bsce26023/LFR/Custom Sensor Array/Sensor Array.pdf

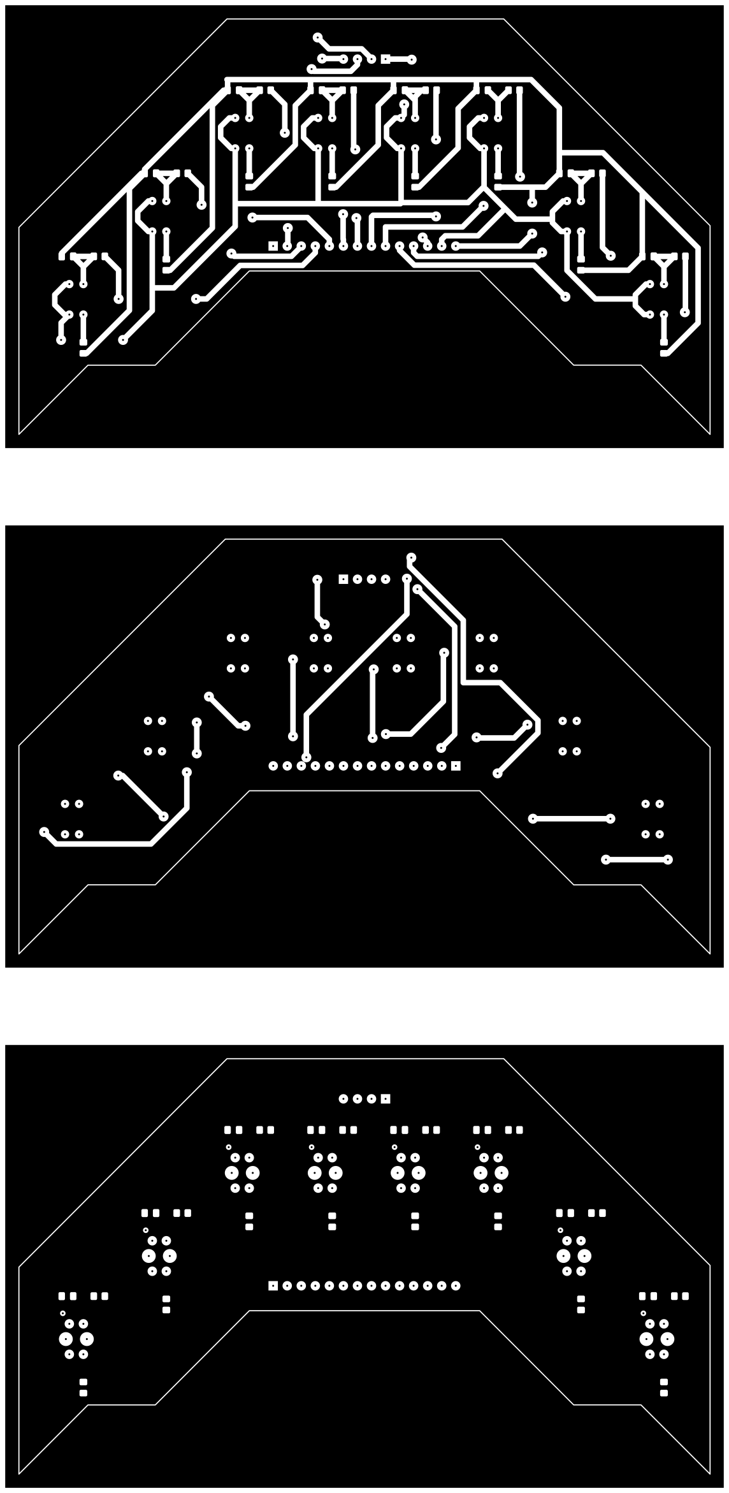
[picture p10: page 1]
