bsce26023/LFR/3D/Images/1.JPG

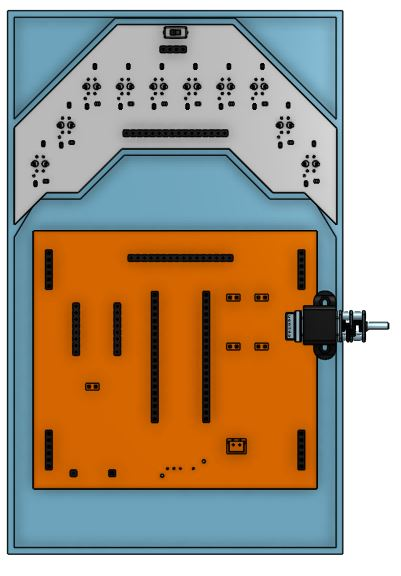
3D/Images/1.JPG
