bsce26023/LFR/3D/Images/2.JPG

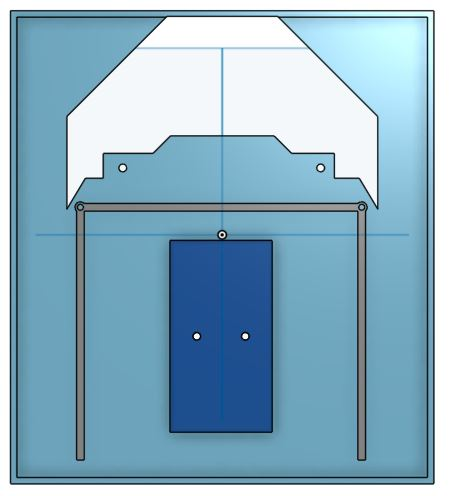
3D/Images/2.JPG
