bsce26023/LFR/3D/Images/3.JPG

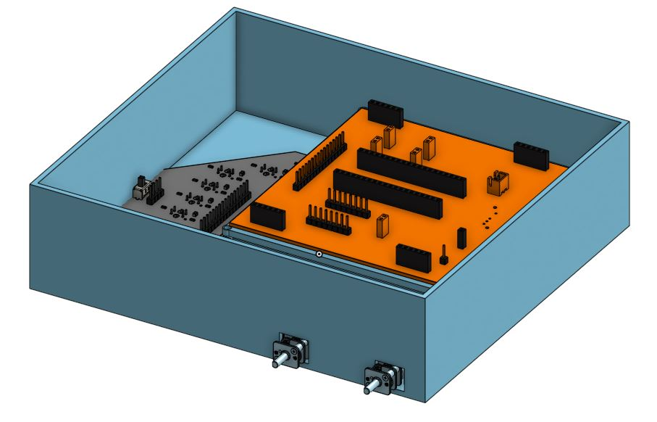
3D/Images/3.JPG
