bsce26023/LFR/3D/Images/4.JPG

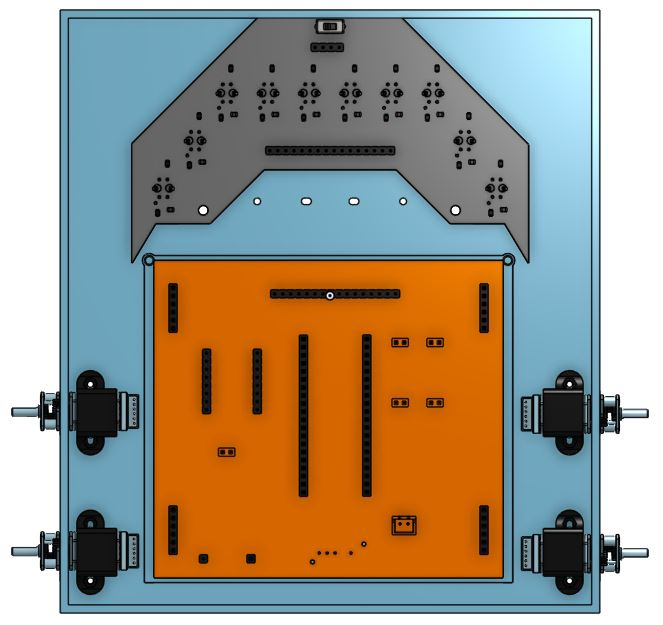
3D/Images/4.JPG
