bsce26023/LFR/3D/Images/6.JPG

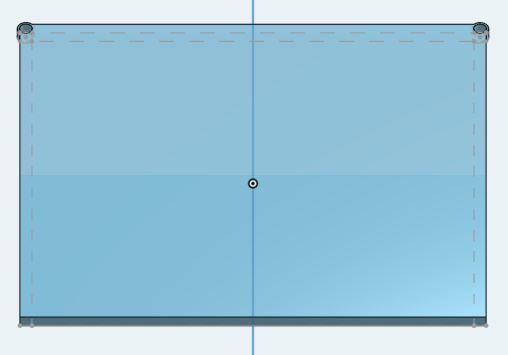
3D/Images/6.JPG
