bsce26023/LFR/Others/Cart ScreenShots/1.JPG

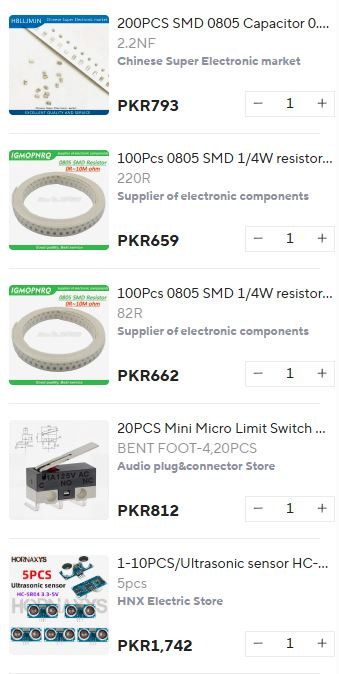
Others/Cart ScreenShots/1.JPG
