bsce26023/LFR/Others/Cart ScreenShots/2.JPG

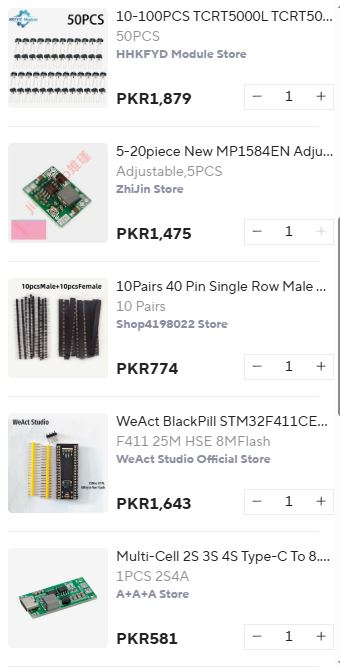
Others/Cart ScreenShots/2.JPG
