bsce26023/LFR/Others/Cart ScreenShots/3.JPG

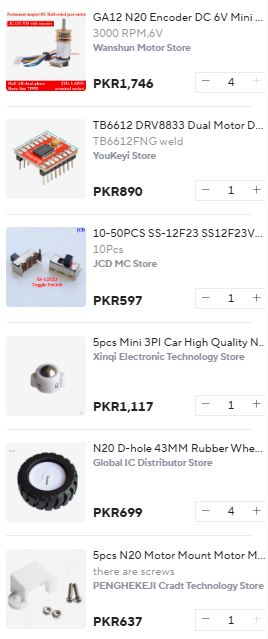
Others/Cart ScreenShots/3.JPG
