bsce26023/LFR/Others/Cart ScreenShots/4.JPG

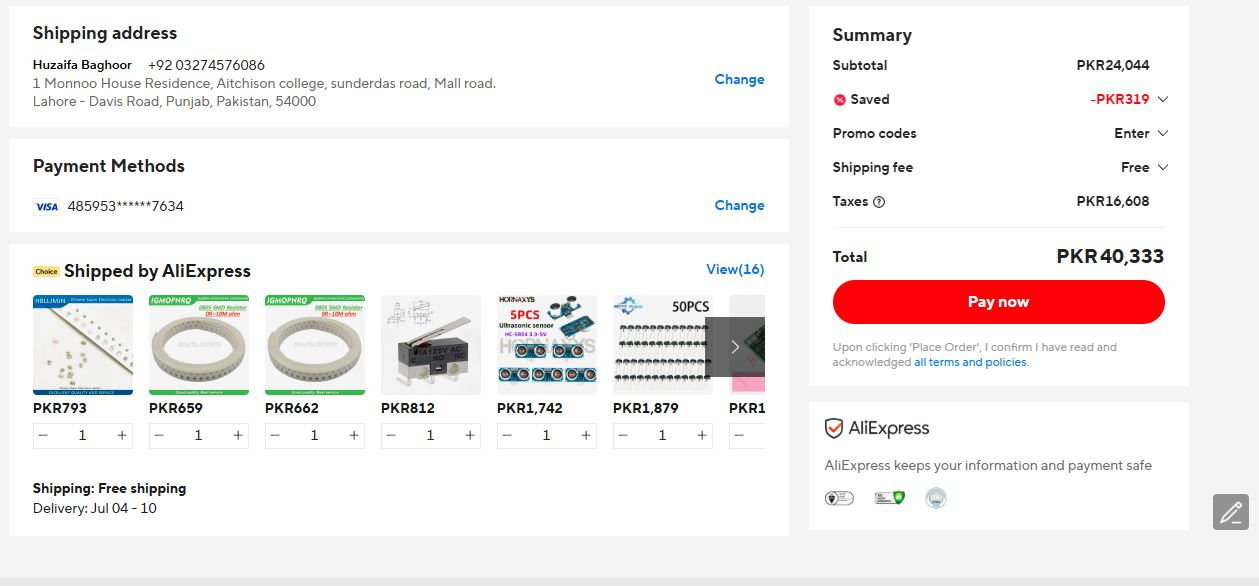
Others/Cart ScreenShots/4.JPG
