bsce26023/LFR/Others/Cart ScreenShots/JLC.JPG

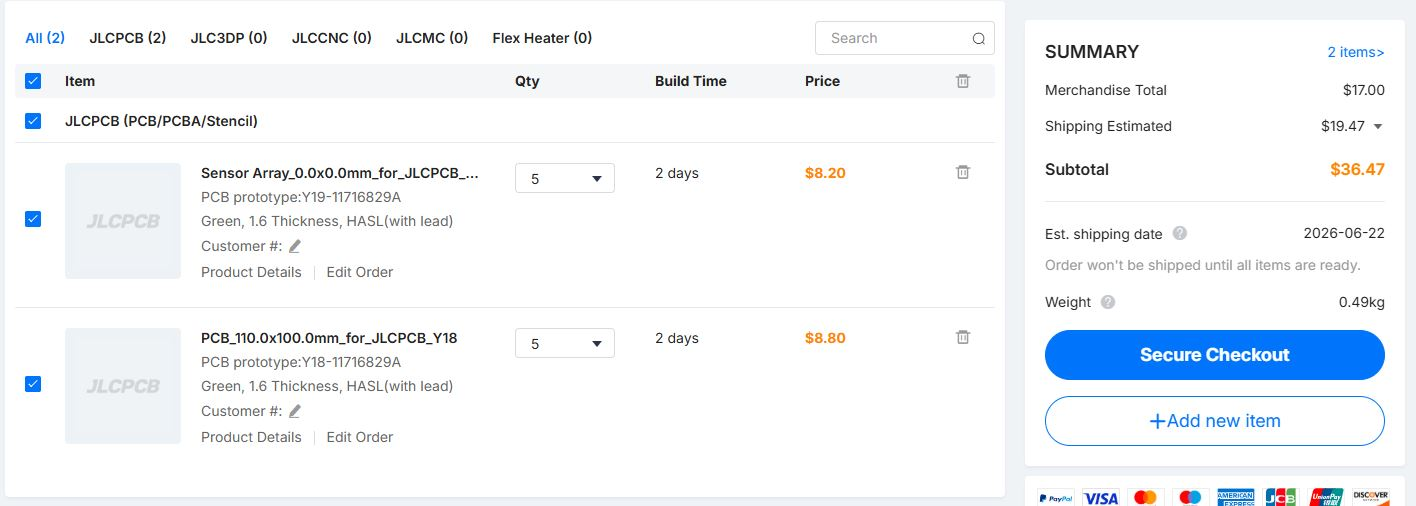
Others/Cart ScreenShots/JLC.JPG
