bsce26023/LFR/Custom Sensor Array/Sensor Array.csv

Id | Designator | Footprint | Quantity | Designation | Supplier and ref
1 | R6,R8,R11,R12,R4,R7,R2,R9,R5,R3,R15,R1,R17,R18,R20,R10,R13,R16,R19,R14 | R_0805_2012Metric_Pad1.20x1.40mm_HandSolder | 20 | R
2 | C5,C6,C3,C1,C2,C7,C8,C10,C4,C9 | C_0805_2012Metric_Pad1.18x1.45mm_HandSolder | 10 | 2.2nF
3 | SW1 | SW_Slide_SPDT_Straight_CK_OS102011MS2Q | 1 | SW_SPDT
4 | J2 | PinHeader_1x04_P2.54mm_Vertical | 1 | Conn_01x04
5 | J3 | PinHeader_1x16_P2.54mm_Vertical | 1 | Conn_01x16
6 | U8,U1,U9,U4,U10,U6,U2,U7,U3,U5 | tcrt5000 | 10 | TCRT5000
