bsce26023/LFR/3D/Assembly .step

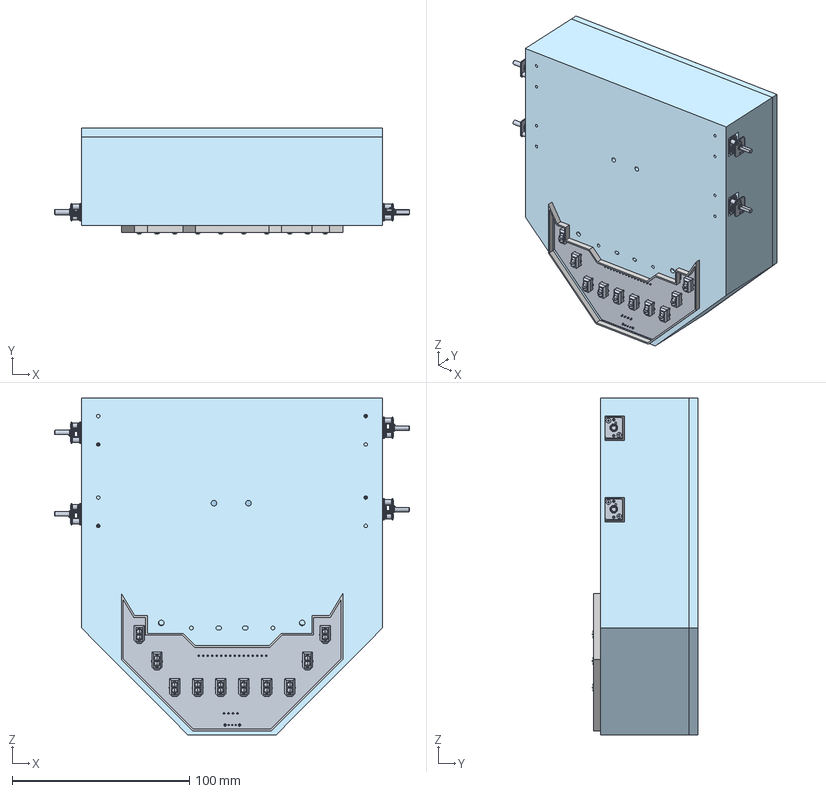
[picture p21: CAD file, 2026-07-14]
3D/Assembly .step
200.4 x 59.8 x 190.0 mm
N20 Mini Micro Metall Gear Motor DC 3-6-12V v1 v1 x 116
TCRT5000--3DModel-STEP-56544_9 x 7
R_0805_2012Metric_11
TCRT5000--3DModel-STEP-56544_3 x 7
R_0805_2012Metric_10
TCRT5000--3DModel-STEP-56544_6 x 7
TCRT5000--3DModel-STEP-56544_8 x 7
R_0805_2012Metric_9
SW_Slide_SPDT_Straight_CK_OS102011MS2Q x 6
PinHeader_1x04_P2.54mm_Vertical
TCRT5000--3DModel-STEP-56544_1 x 7
TCRT5000--3DModel-STEP-56544_4 x 7
R_0805_2012Metric_8
TCRT5000--3DModel-STEP-56544_5 x 7
R_0805_2012Metric_7
C_0805_2012Metric_1
R_0805_2012Metric_19
R_0805_2012Metric_18
C_0805_2012Metric
Sensor Array_PCB
R_0805_2012Metric_6
R_0805_2012Metric_13
C_0805_2012Metric_9
C_0805_2012Metric_6
TCRT5000--3DModel-STEP-56544_2 x 7
TCRT5000--3DModel-STEP-56544 x 7
R_0805_2012Metric_5
R_0805_2012Metric_4
C_0805_2012Metric_2
R_0805_2012Metric_3
TCRT5000--3DModel-STEP-56544_7 x 7
R_0805_2012Metric_2
R_0805_2012Metric_15
R_0805_2012Metric_1
Sensor Array_soldermask x 2
R_0805_2012Metric
R_0805_2012Metric_16
R_0805_2012Metric_17
C_0805_2012Metric_7
C_0805_2012Metric_8
R_0805_2012Metric_12
PinHeader_1x16_P2.54mm_Vertical x 2
C_0805_2012Metric_5
R_0805_2012Metric_14
C_0805_2012Metric_3
C_0805_2012Metric_4
PinHeader_1x08_P2.54mm_Vertical_1
PinSocket_1x02_P2.54mm_Vertical_2
PinSocket_1x06_P2.54mm_Vertical_2
PinSocket_1x02_P2.54mm_Vertical_4
PinSocket_1x06_P2.54mm_Vertical_3
PinSocket_1x02_P2.54mm_Vertical_1
PinSocket_1x06_P2.54mm_Vertical_1
PCB_soldermask x 2
PinSocket_1x20_P2.54mm_Vertical_1
PinSocket_1x20_P2.54mm_Vertical
PinSocket_1x02_P2.54mm_Vertical_3
JST_XH_B2B-XH-A_1x02_P2.50mm_Vertical
PinSocket_1x02_P2.54mm_Vertical
PinSocket_1x01_P2.54mm_Vertical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
