bsce26023/LFR/3D/Models/BLM Blossom Electronics STM THM FOR 18650 Battery Holder With Nickel Strip And Battery V1.3.STEP

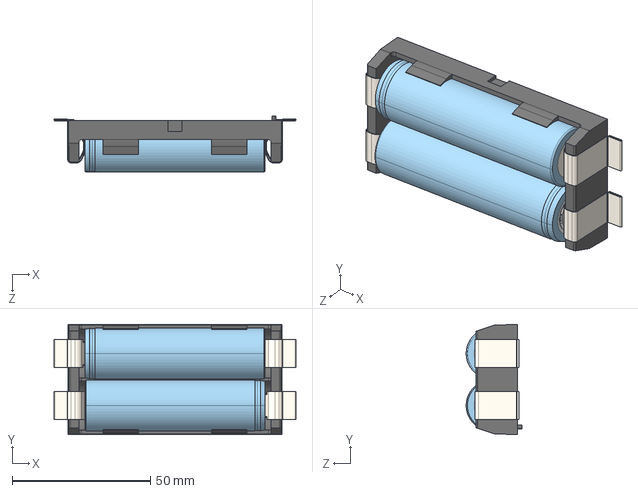
[picture p22: CAD file, 2026-06-20]
3D/Models/BLM Blossom Electronics STM THM FOR 18650 Battery Holder With Nickel Strip And Battery V1.3.STEP
87.5 x 39.8 x 20.2 mm
