bsce26023/LFR/Custom Sensor Array/Exports/Sensor Array.step

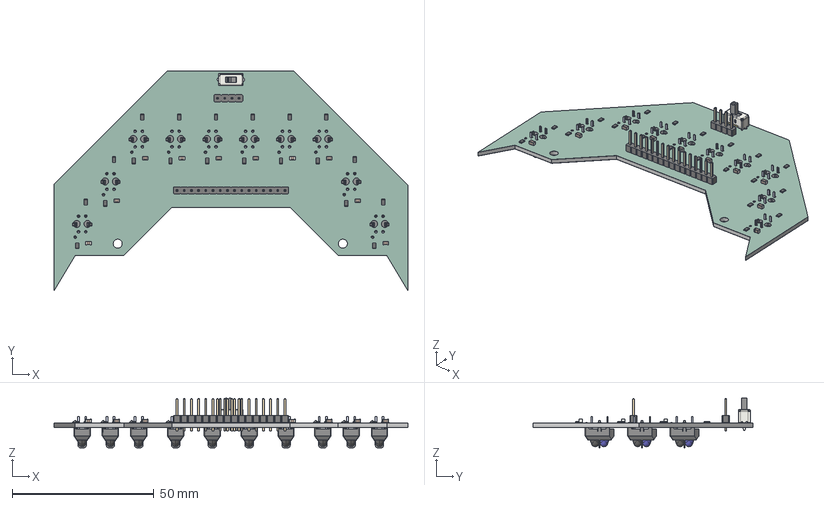
[picture p23: CAD file, 2026-06-20]
Custom Sensor Array/Exports/Sensor Array.step
125.0 x 77.6 x 17.6 mm
R_0805_2012Metric x 20
C_0805_2012Metric x 10
SW_Slide_SPDT_Straight_CK_OS102011MS2Q
PinHeader_1x04_P2.54mm_Vertical
PinHeader_1x16_P2.54mm_Vertical
TCRT5000--3DModel-STEP-56544 x 10
Sensor Array_soldermask x 2
Sensor Array_PCB
