bsce26023/LFR/Main Board/Exports/PCB.step

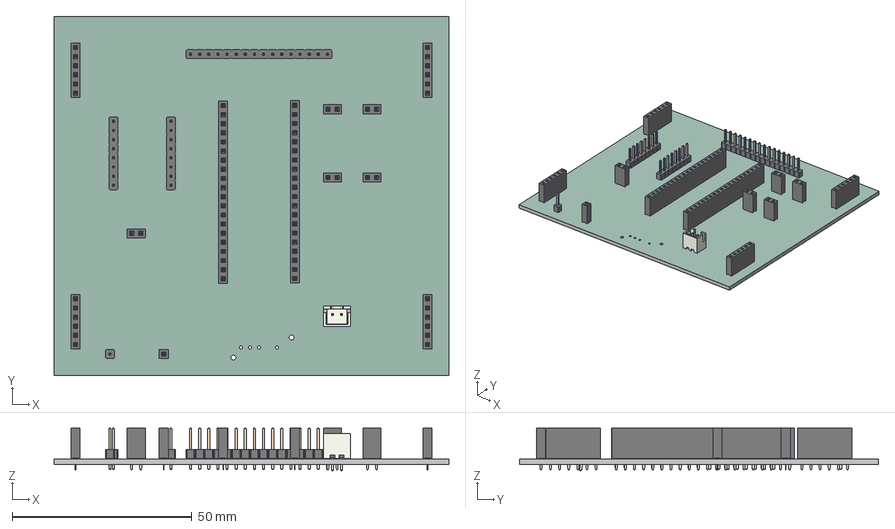
[picture p24: CAD file, 2026-06-18]
Main Board/Exports/PCB.step
110.0 x 100.0 x 11.9 mm
PinHeader_1x08_P2.54mm_Vertical x 2
PinSocket_1x06_P2.54mm_Vertical x 4
PinSocket_1x02_P2.54mm_Vertical x 5
PinSocket_1x20_P2.54mm_Vertical x 2
PinHeader_1x16_P2.54mm_Vertical
PinHeader_1x01_P2.54mm_Vertical
PinSocket_1x01_P2.54mm_Vertical
JST_XH_B2B-XH-A_1x02_P2.50mm_Vertical
PCB_soldermask x 2
PCB_PCB
