bsce26023/LFR/3D/Chasis.step

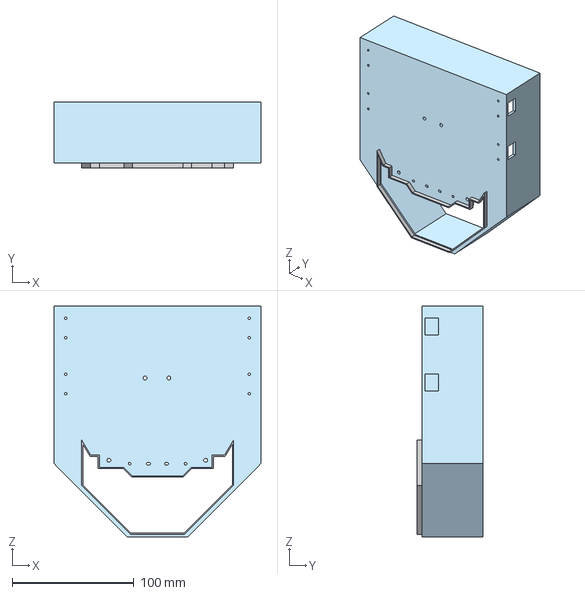
[picture p25: CAD file, 2026-06-20]
3D/Chasis.step
170.0 x 54.0 x 190.0 mm
