bsce26023/LFR/3D/Models/N20 Mini Micro Metall Gear Motor.step

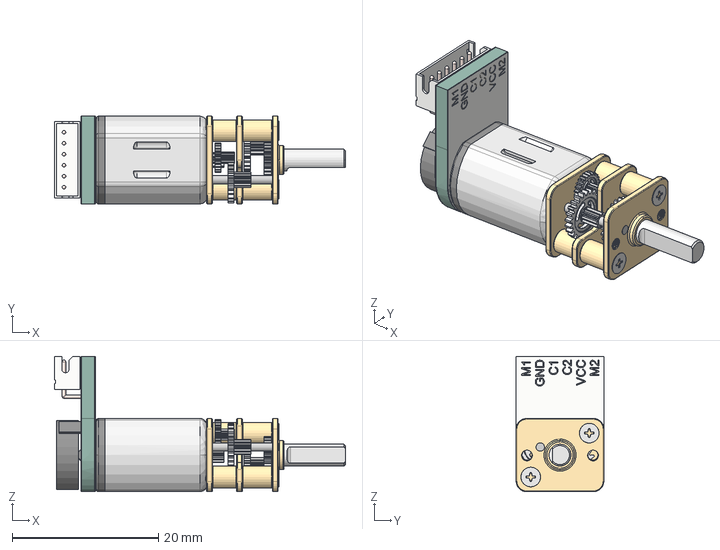
[picture p26: CAD file, 2026-06-20]
3D/Models/N20 Mini Micro Metall Gear Motor.step
39.8 x 12.0 x 18.5 mm
