bsce26023/LFR/3D/Lid (1).3mf

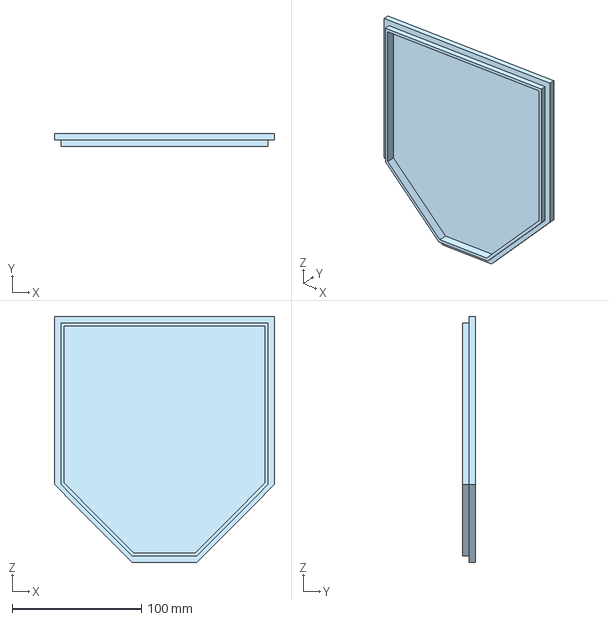
[picture p27: CAD file, 2026-06-20]
3D/Lid (1).3mf
170.0 x 10.0 x 190.0 mm
