bsce26023/LFR/3D/PCB Plate.step

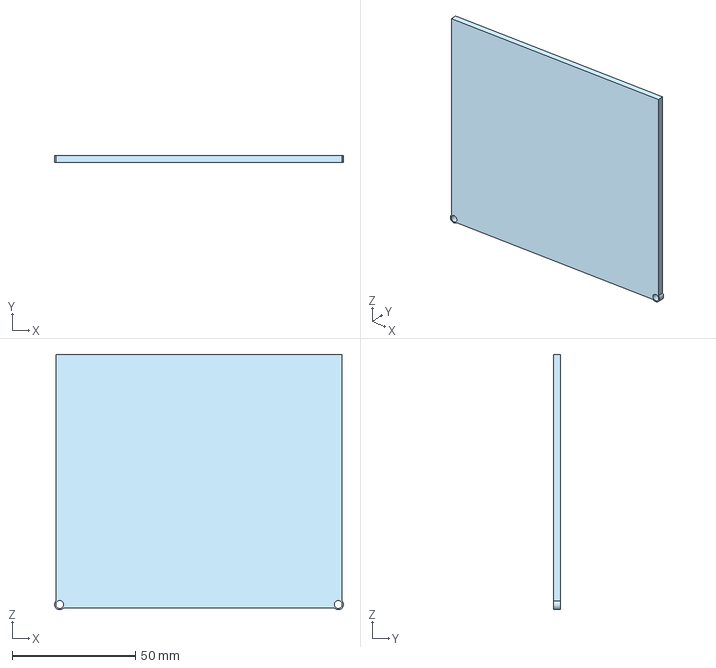
[picture p28: CAD file, 2026-06-20]
3D/PCB Plate.step
117.2 x 3.00 x 103.6 mm
