bsce26023/LFR/(list of files, cad)

Other CAD files:
3D/Lid.step
3D/Chasis.3mf
3D/PCB Plate.3mf
