bsce26023/LFR/Journals/1.webp

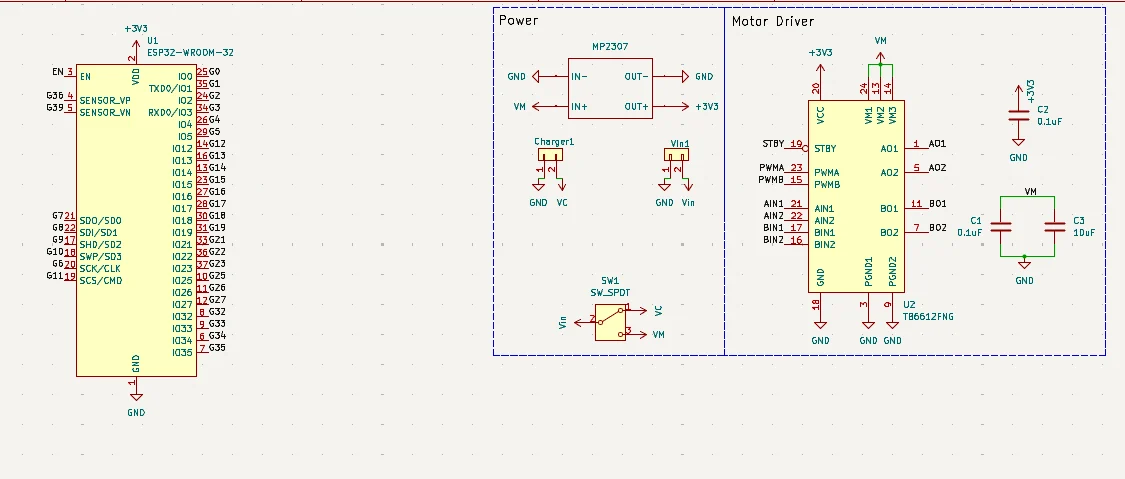
Journals/1.webp
