bsce26023/LFR/Journals/2.1.webp

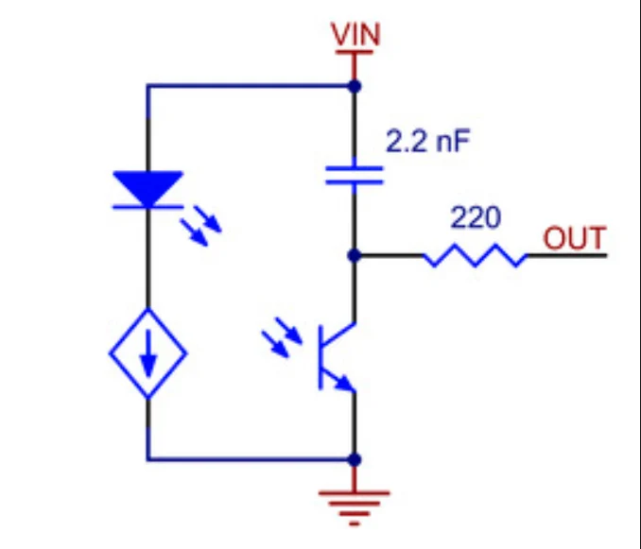
Journals/2.1.webp
