bsce26023/LFR/Journals/2.2.jpg

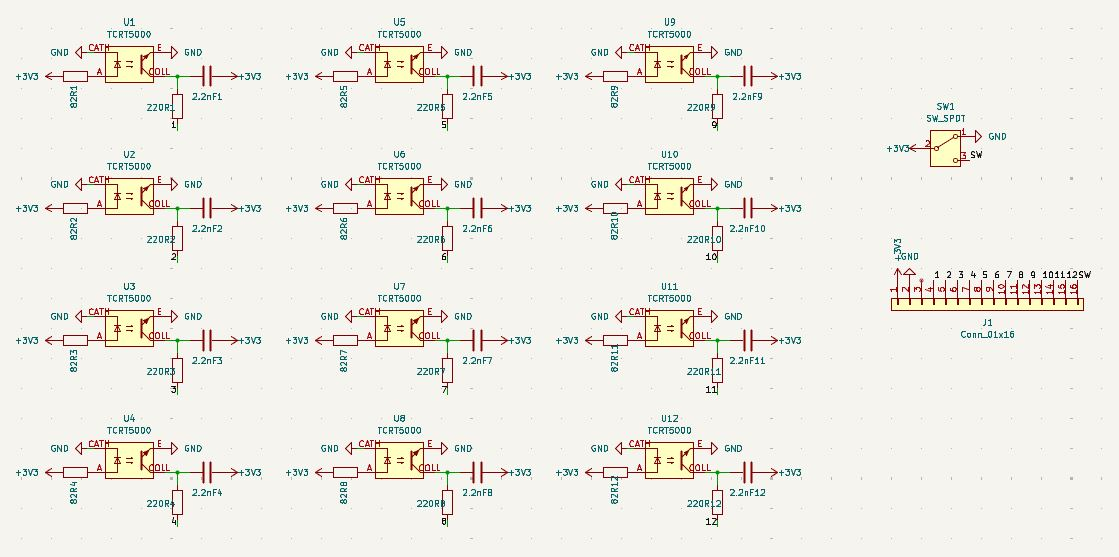
Journals/2.2.jpg
