bsce26023/LFR/Journals/2.3.jpg

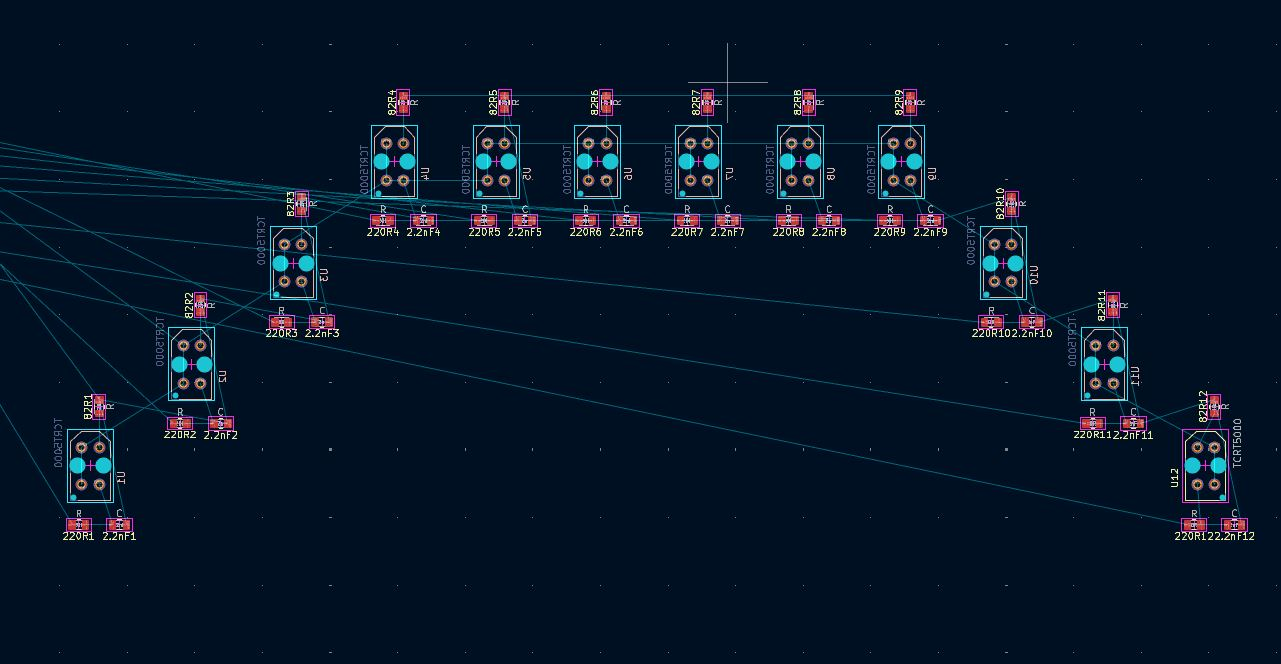
Journals/2.3.jpg
