bsce26023/LFR/Journals/3.1.png

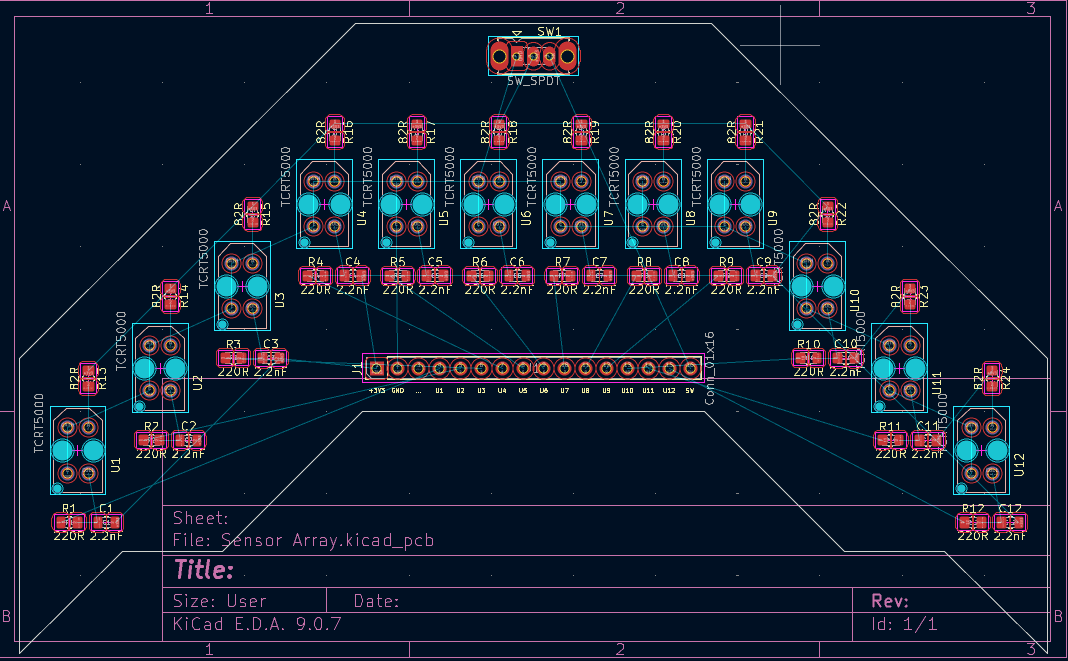
Journals/3.1.png
