bsce26023/LFR/Journals/3.2.png

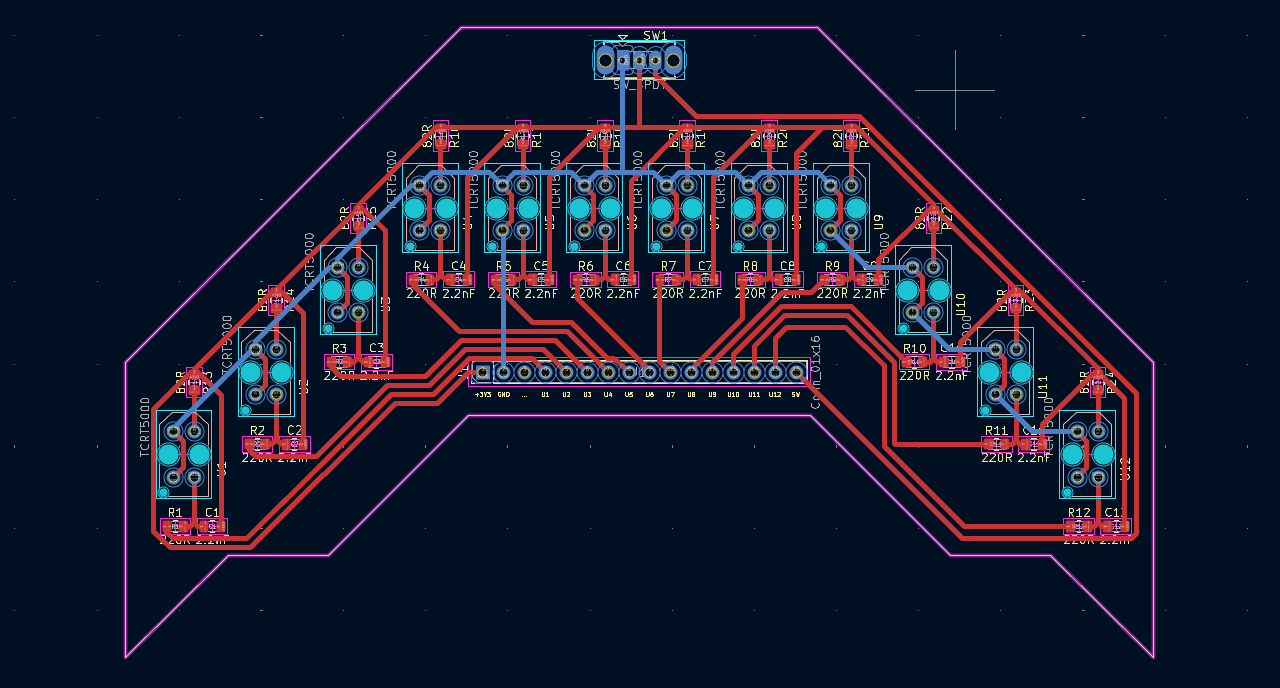
Journals/3.2.png
