bsce26023/LFR/Journals/3.3.png

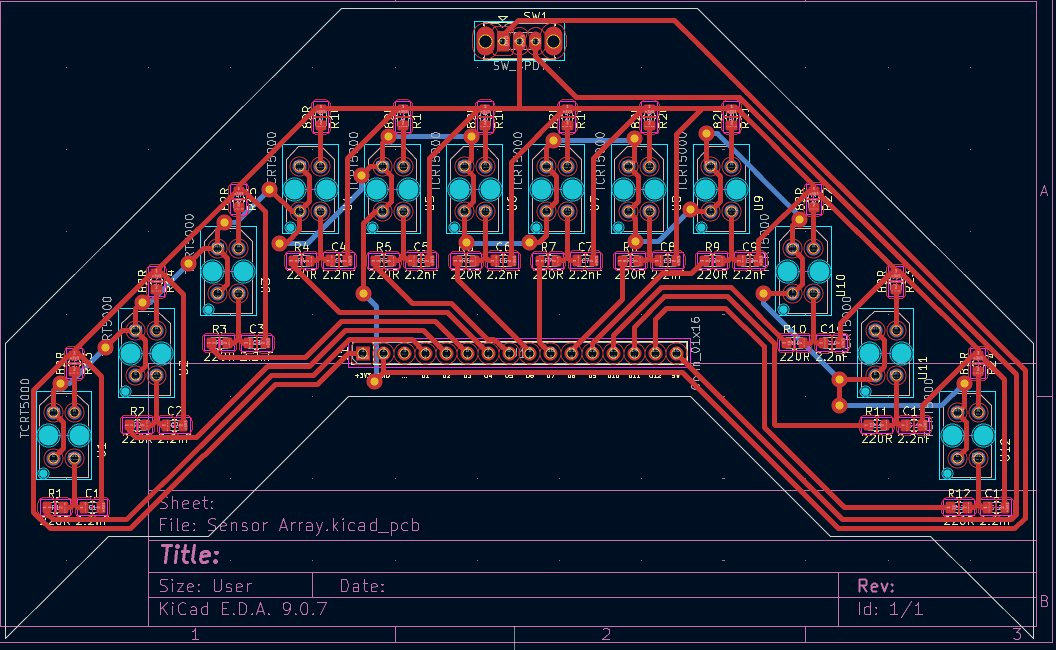
Journals/3.3.png
