bsce26023/LFR/Journals/4.png

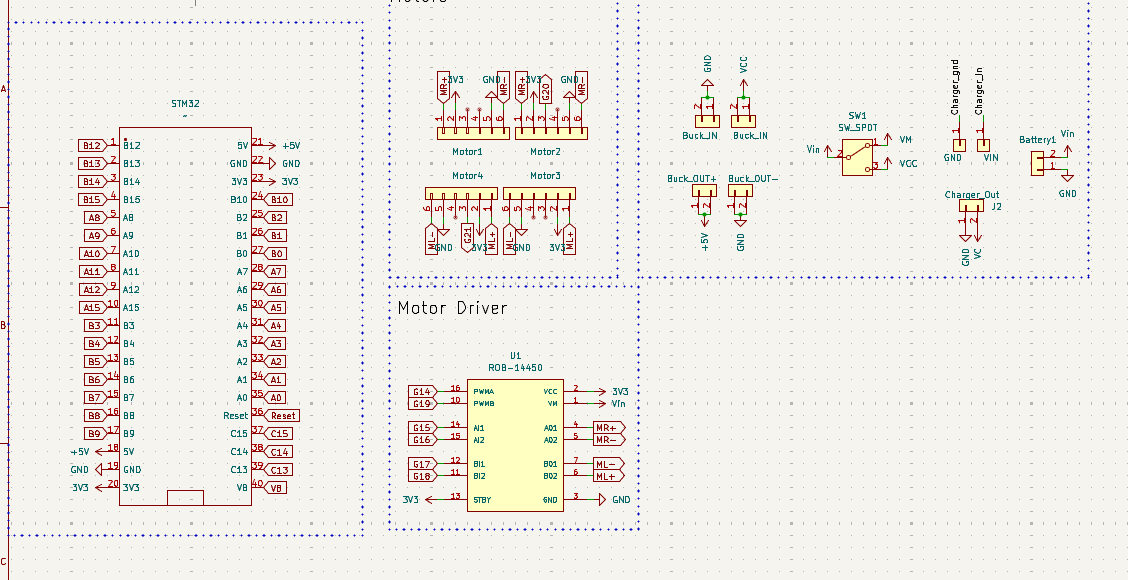
Journals/4.png
