bsce26023/LFR/Journals/6.png

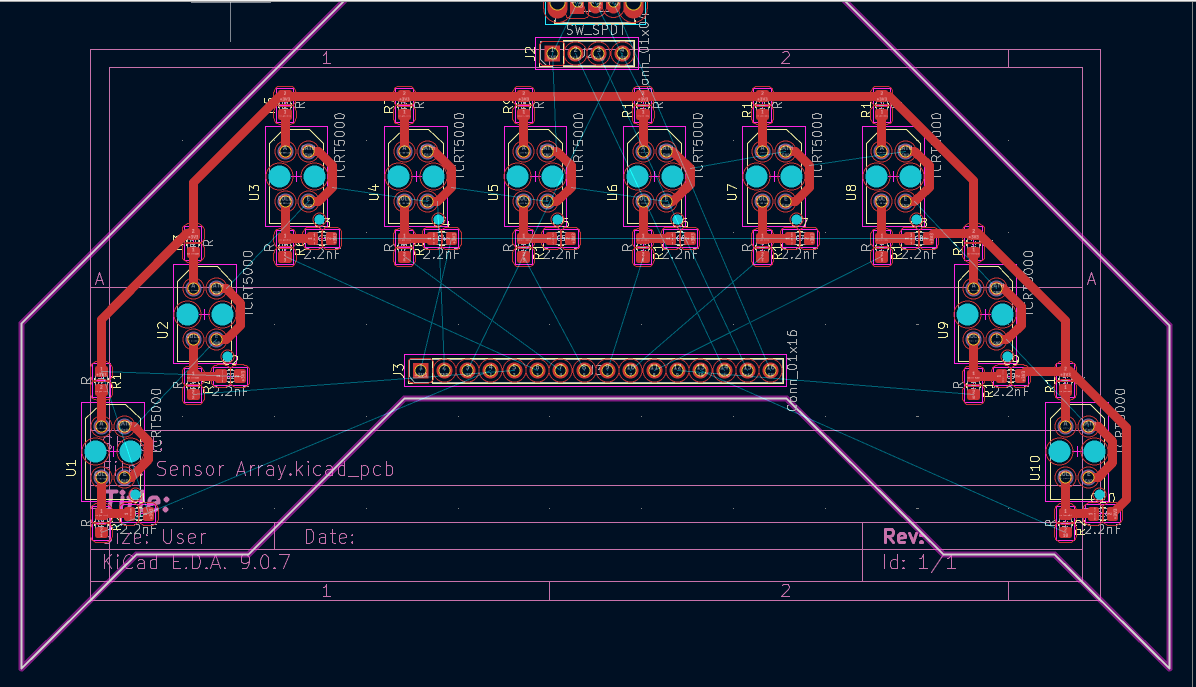
Journals/6.png
