bsce26023/LFR/Sensor Array/Sensor Array A6.pdf

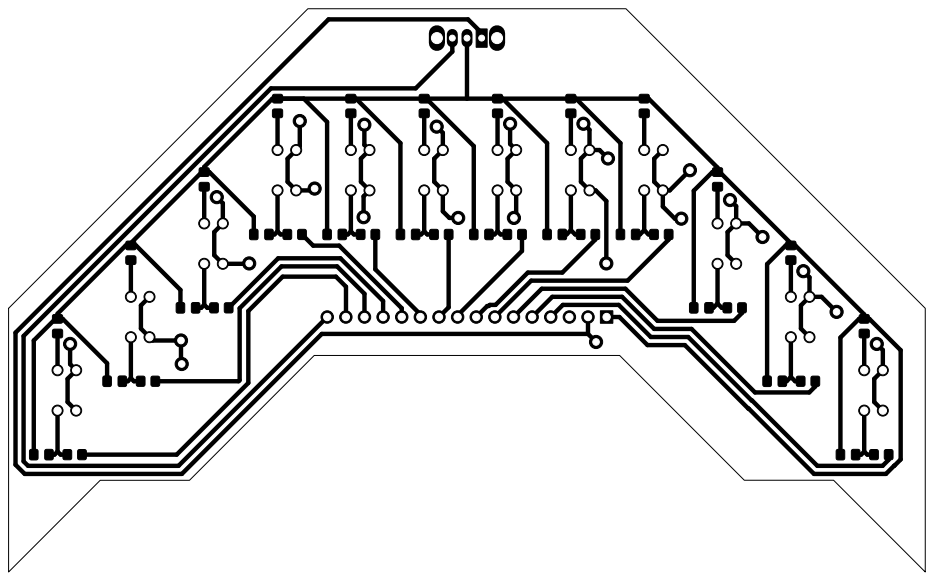
[picture p43: page 1]

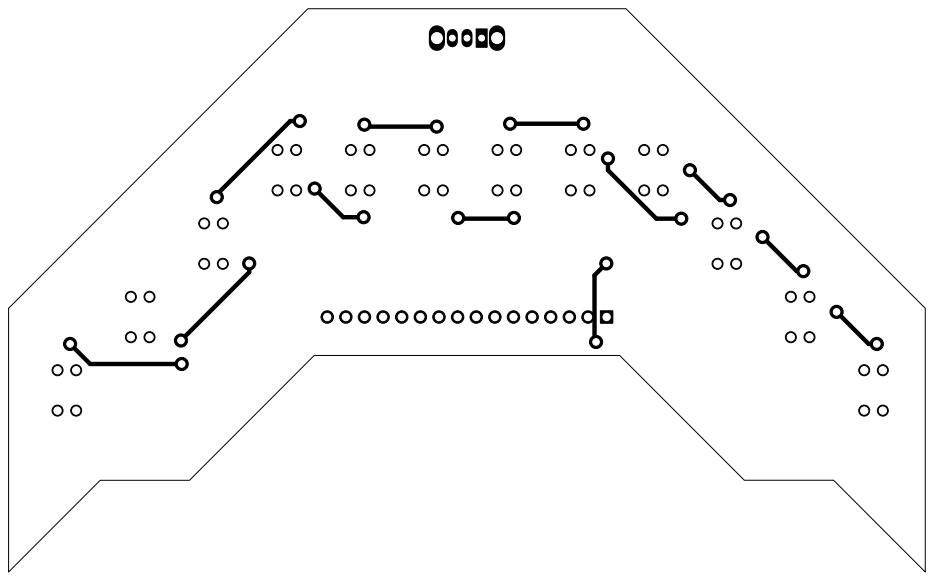
[picture p44: page 2]
