bsce26023/LFR/(list of files, drawings)

Other design files:
Custom Sensor Array/freerouting.dsn
Custom Sensor Array/temp-freerouting.dsn
