bsce26023/LFR/Main Board/PCB.kicad_pcb

## KiCad design Main Board/PCB.kicad_pcb (2026-07-10)

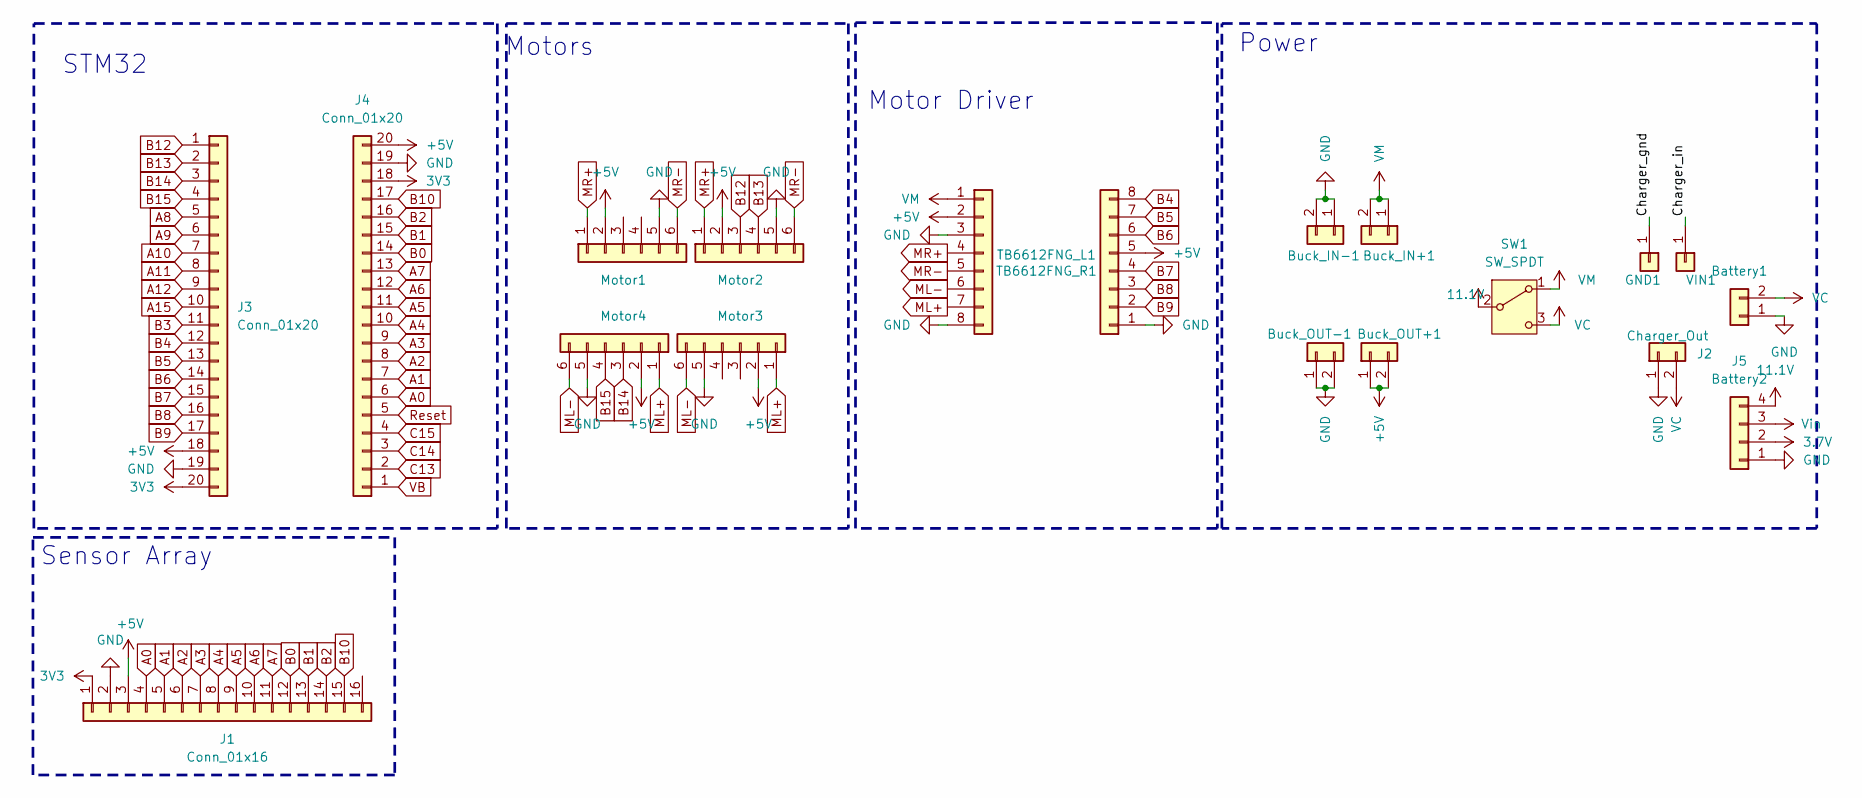
[picture p45: schematic PCB.kicad_sch]

Parts:
Battery1: Conn_01x02; AMASS_XT60-M_1x02_P7.20mm_Vertical
Buck_IN+1: Conn_01x02; PinSocket_1x02_P2.54mm_Vertical
Buck_IN-1: Conn_01x02; PinSocket_1x02_P2.54mm_Vertical
Buck_OUT+1: Conn_01x02; PinSocket_1x02_P2.54mm_Vertical
Buck_OUT-1: Conn_01x02; PinSocket_1x02_P2.54mm_Vertical
GND1: Conn_01x01; PinSocket_1x01_P2.54mm_Vertical
J1: Conn_01x16; PinHeader_1x16_P2.54mm_Vertical
J2: Charger_Out; PinSocket_1x02_P2.54mm_Vertical
J3, J4: Conn_01x20; PinSocket_1x20_P2.54mm_Vertical
J5: Battery2; JST_XH_B4B-XH-A_1x04_P2.50mm_Vertical
Motor1, Motor2, Motor3, Motor4: Conn_01x06; PinSocket_1x06_P2.54mm_Vertical
SW1: SW_SPDT; SW_Slide_SP3T_Straight_CK_OS103012MU1QP1
TB6612FNG_L1, TB6612FNG_R1: Conn_01x08; PinHeader_1x08_P2.54mm_Vertical
VIN1: Conn_01x01; PinHeader_1x01_P2.54mm_Vertical

Connections:
3.7V: J5.2
3V3: J1.1, J3.20, J4.18
+5V: Buck_OUT+1.1, Buck_OUT+1.2, J1.3, J3.18, J4.20, Motor1.2, Motor2.2, Motor3.2, Motor4.2, TB6612FNG_L1.2, TB6612FNG_R1.5
/Charger_gnd: GND1.1
/Charger_in: VIN1.1
A0: J1.4, J4.6
A1: J1.5, J4.7
A2: J1.6, J4.8
A3: J1.7, J4.9
A4: J1.8, J4.10
A5: J1.9, J4.11
A6: J1.10, J4.12
A7: J1.11, J4.13
A8: J3.5
A9: J3.6
A10: J3.7
A11: J3.8
A12: J3.9
A15: J3.10
B0: J1.12, J4.14
B1: J1.13, J4.15
B2: J1.14, J4.16
B3: J3.11
B4: J3.12, TB6612FNG_R1.8
B5: J3.13, TB6612FNG_R1.7
B6: J3.14, TB6612FNG_R1.6
B7: J3.15, TB6612FNG_R1.4
B8: J3.16, TB6612FNG_R1.3
B9: J3.17, TB6612FNG_R1.2
B10: J1.15, J4.17
B12: J3.1, Motor2.3
B13: J3.2, Motor2.4
B14: J3.3, Motor4.3
B15: J3.4, Motor4.4
C13: J4.2
C14: J4.3
C15: J4.4
GND: Battery1.1, Buck_IN-1.1, Buck_IN-1.2, Buck_OUT-1.1, Buck_OUT-1.2, J1.2, J2.1, J3.19, J4.19, J5.1, Motor1.5, Motor2.5, Motor3.5, Motor4.5, TB6612FNG_L1.3, TB6612FNG_L1.8, TB6612FNG_R1.1
ML+: Motor3.1, Motor4.1, TB6612FNG_L1.7
ML-: Motor3.6, Motor4.6, TB6612FNG_L1.6
MR+: Motor1.1, Motor2.1, TB6612FNG_L1.4
MR-: Motor1.6, Motor2.6, TB6612FNG_L1.5
Reset: J4.5
VB: J4.1
VM: Buck_IN+1.1, Buck_IN+1.2, SW1.1 (A), TB6612FNG_L1.1
Vin: J5.3

Notes on the sheet:
Power
Motor Driver
STM32
Motors
Sensor Array

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
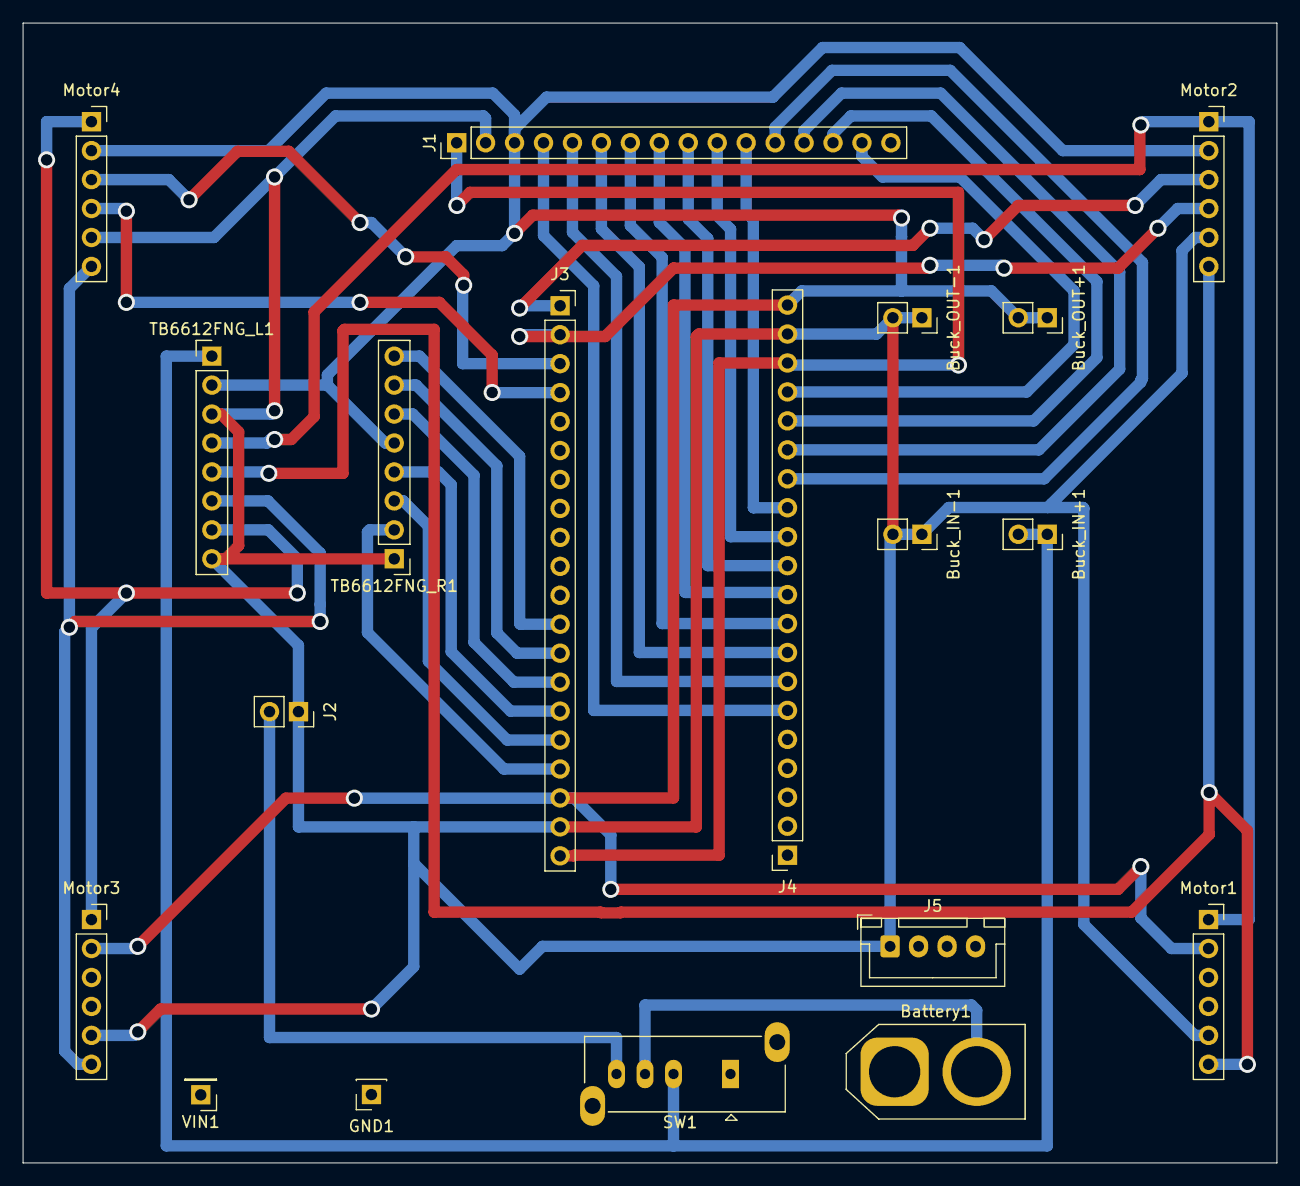
[picture p46: board PCB.kicad_pcb from above]

Board: 2 copper layers, 110.0 x 100.0 mm, 19 parts (0 on the bottom side), 32 nets.
