bsce26023/LFR/Custom Sensor Array/Sensor Array.kicad_pcb

## KiCad design Custom Sensor Array/Sensor Array.kicad_pcb (2026-07-08)

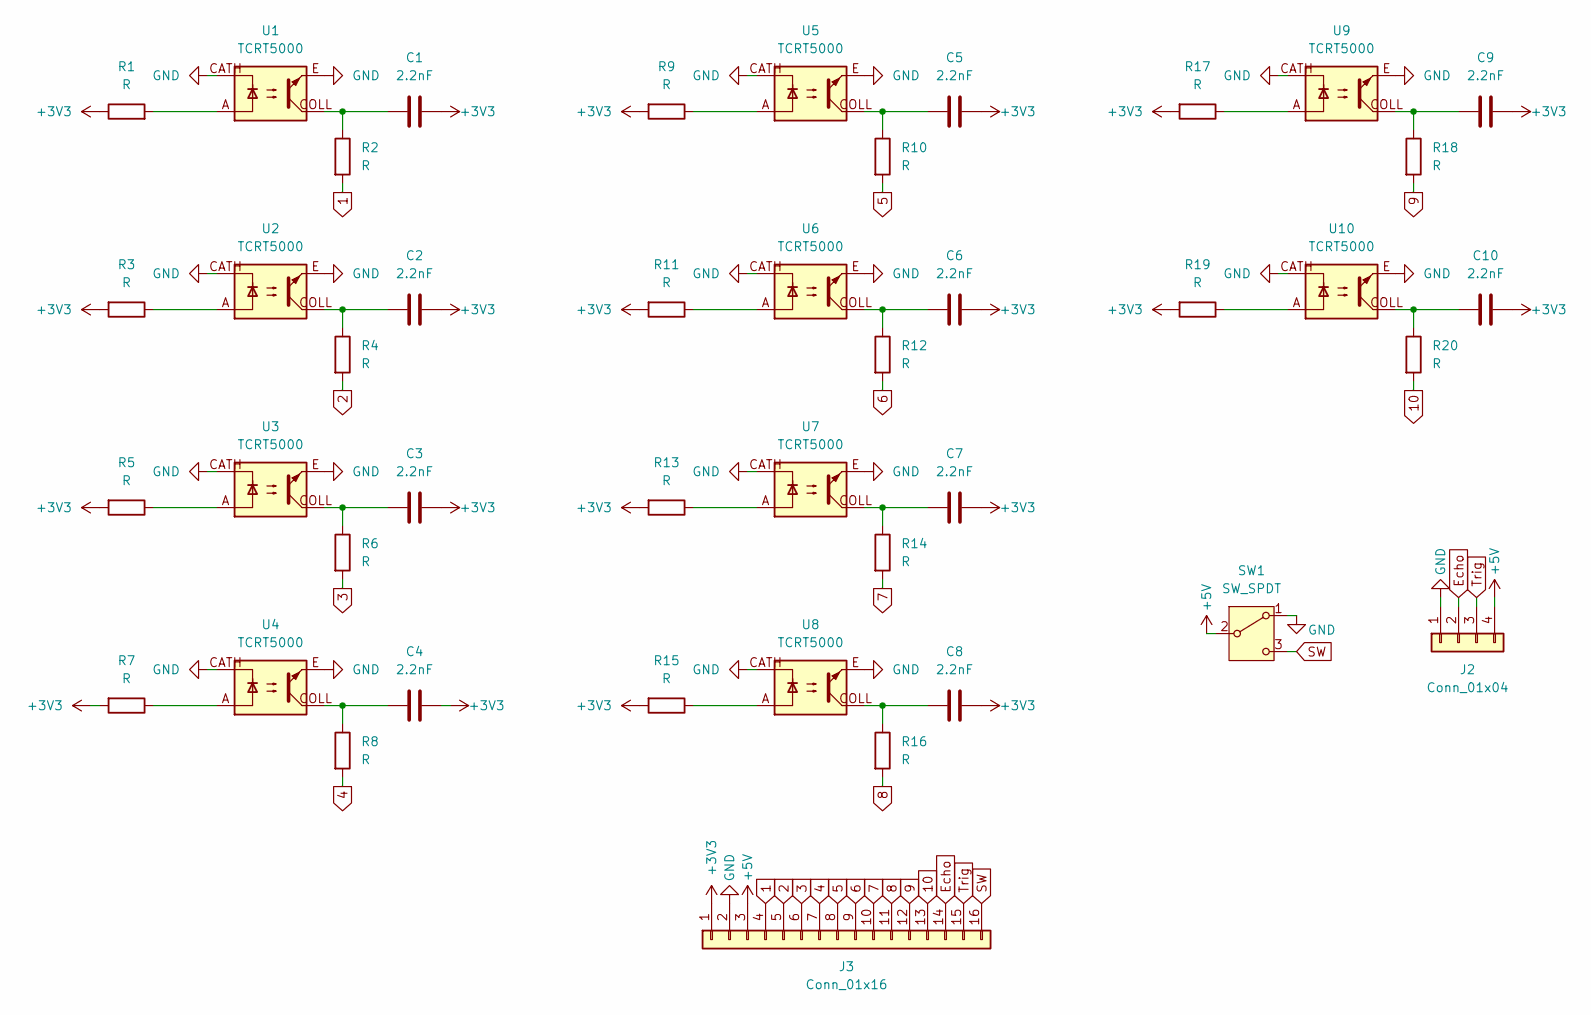
[picture p47: schematic Sensor Array.kicad_sch]

Parts:
C1, C2, C3, C4, C5, C6, C7, C8, C9, C10: 2.2nF; C_0805_2012Metric_Pad1.18x1.45mm_HandSolder
J2: Conn_01x04; PinHeader_1x04_P2.54mm_Vertical
J3: Conn_01x16; PinHeader_1x16_P2.54mm_Vertical
R1, R2, R3, R4, R5, R6, R7, R8, R9, R10, R11, R12, R13, R14, R15, R16, R17, R18, R19, R20: R; R_0805_2012Metric_Pad1.20x1.40mm_HandSolder
SW1: SW_SPDT; SW_Slide_SPDT_Straight_CK_OS102011MS2Q
U1, U2, U3, U4, U5, U6, U7, U8, U9, U10: TCRT5000; tcrt5000

Connections:
1: J3.4, R2.2
2: J3.5, R4.2
3: J3.6, R6.2
4: J3.7, R8.2
5: J3.8, R10.2
6: J3.9, R12.2
7: J3.10, R14.2
8: J3.11, R16.2
9: J3.12, R18.2
10: J3.13, R20.2
+3V3: C1.2, C2.2, C3.2, C4.2, C5.2, C6.2, C7.2, C8.2, C9.2, C10.2, J3.1, R1.1, R3.2, R5.2, R7.2, R9.2, R11.2, R13.2, R15.2, R17.2, R19.2
+5V: J2.4, J3.3, SW1.2 (B)
Echo: J2.2, J3.14
GND: J2.1, J3.2, SW1.1 (A), U1.CATH, U1.E, U2.CATH, U2.E, U3.CATH, U3.E, U4.CATH, U4.E, U5.CATH, U5.E, U6.CATH, U6.E, U7.CATH, U7.E, U8.CATH, U8.E, U9.CATH, U9.E, U10.CATH, U10.E
unnamed: C1.1, R2.1, U1.COLL
unnamed: C2.1, R4.1, U2.COLL
unnamed: C3.1, R6.1, U3.COLL
unnamed: C4.1, R8.1, U4.COLL
unnamed: C5.1, R10.1, U5.COLL
unnamed: C6.1, R12.1, U6.COLL
unnamed: C7.1, R14.1, U7.COLL
unnamed: C8.1, R16.1, U8.COLL
unnamed: C9.1, R18.1, U9.COLL
unnamed: C10.1, R20.1, U10.COLL
unnamed: R1.2, U1.A
unnamed: R3.1, U2.A
unnamed: R5.1, U3.A
unnamed: R7.1, U4.A
unnamed: R9.1, U5.A
unnamed: R11.1, U6.A
unnamed: R13.1, U7.A
unnamed: R15.1, U8.A
unnamed: R17.1, U9.A
unnamed: R19.1, U10.A
SW: J3.16, SW1.3 (C)
Trig: J2.3, J3.15

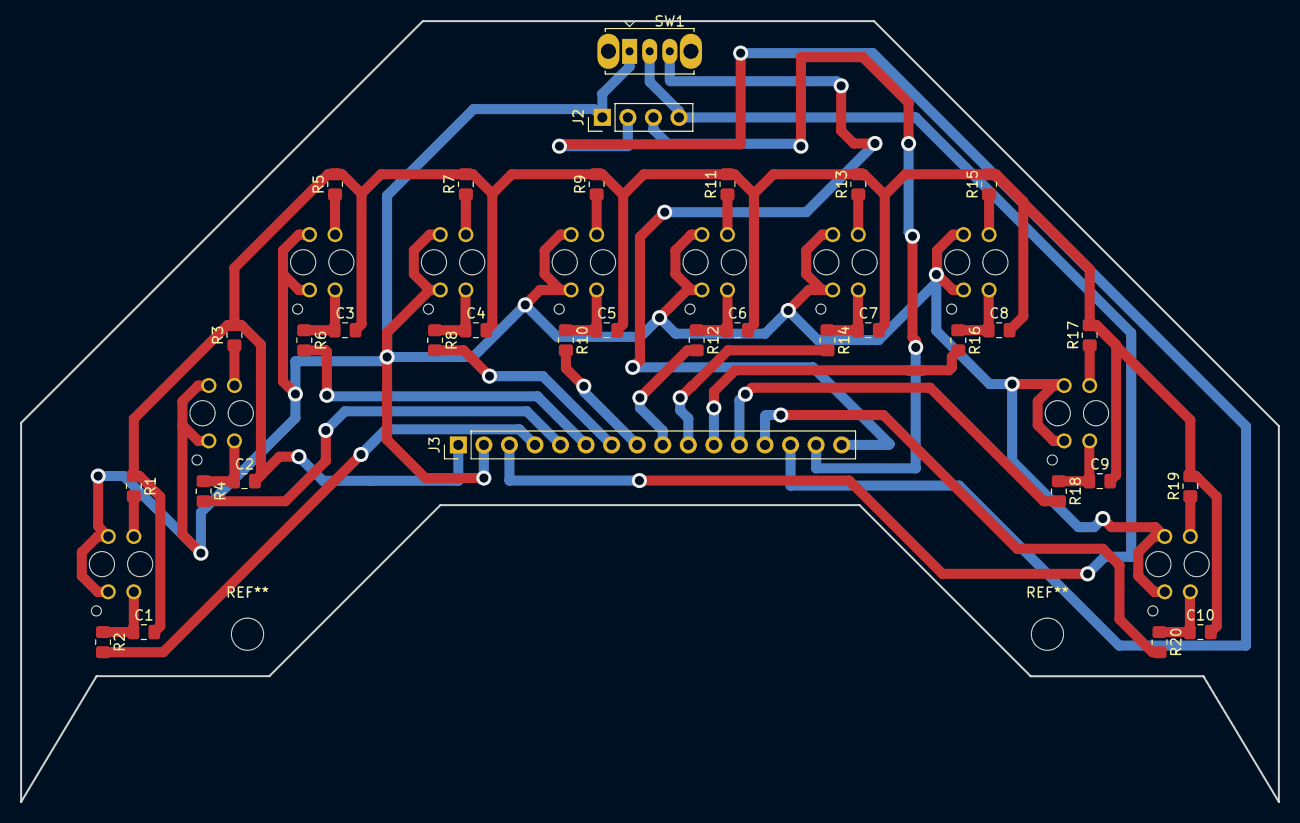
[picture p48: board Custom Sensor Array/Sensor Array.kicad_pcb from above]

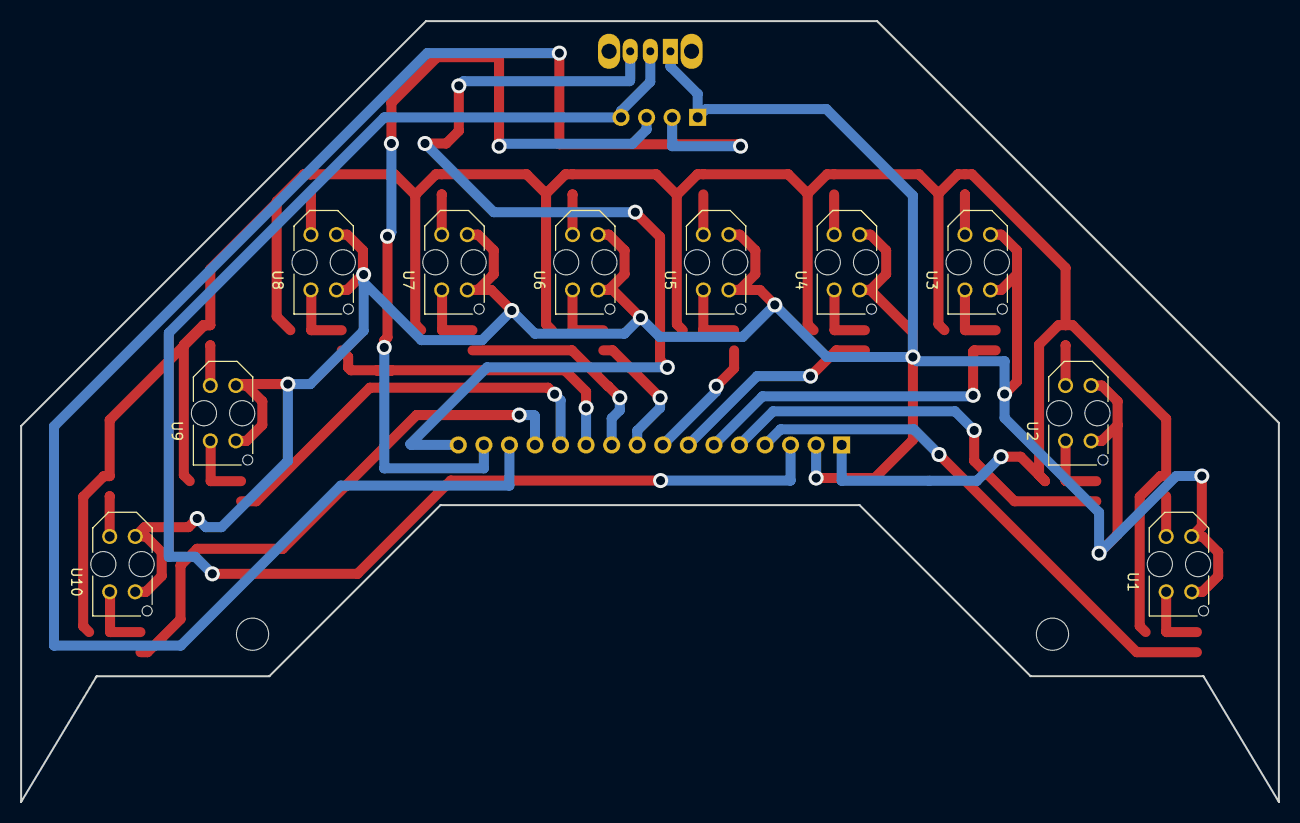
[picture p49: board Custom Sensor Array/Sensor Array.kicad_pcb from below]

Board: 2 copper layers, 125.0 x 77.6 mm, 43 parts (10 on the bottom side), 36 nets.
