bsce26023/LFR/Sensor Array/Sensor Array.kicad_pcb

## KiCad design Sensor Array/Sensor Array.kicad_pcb (2026-05-14, an earlier design)

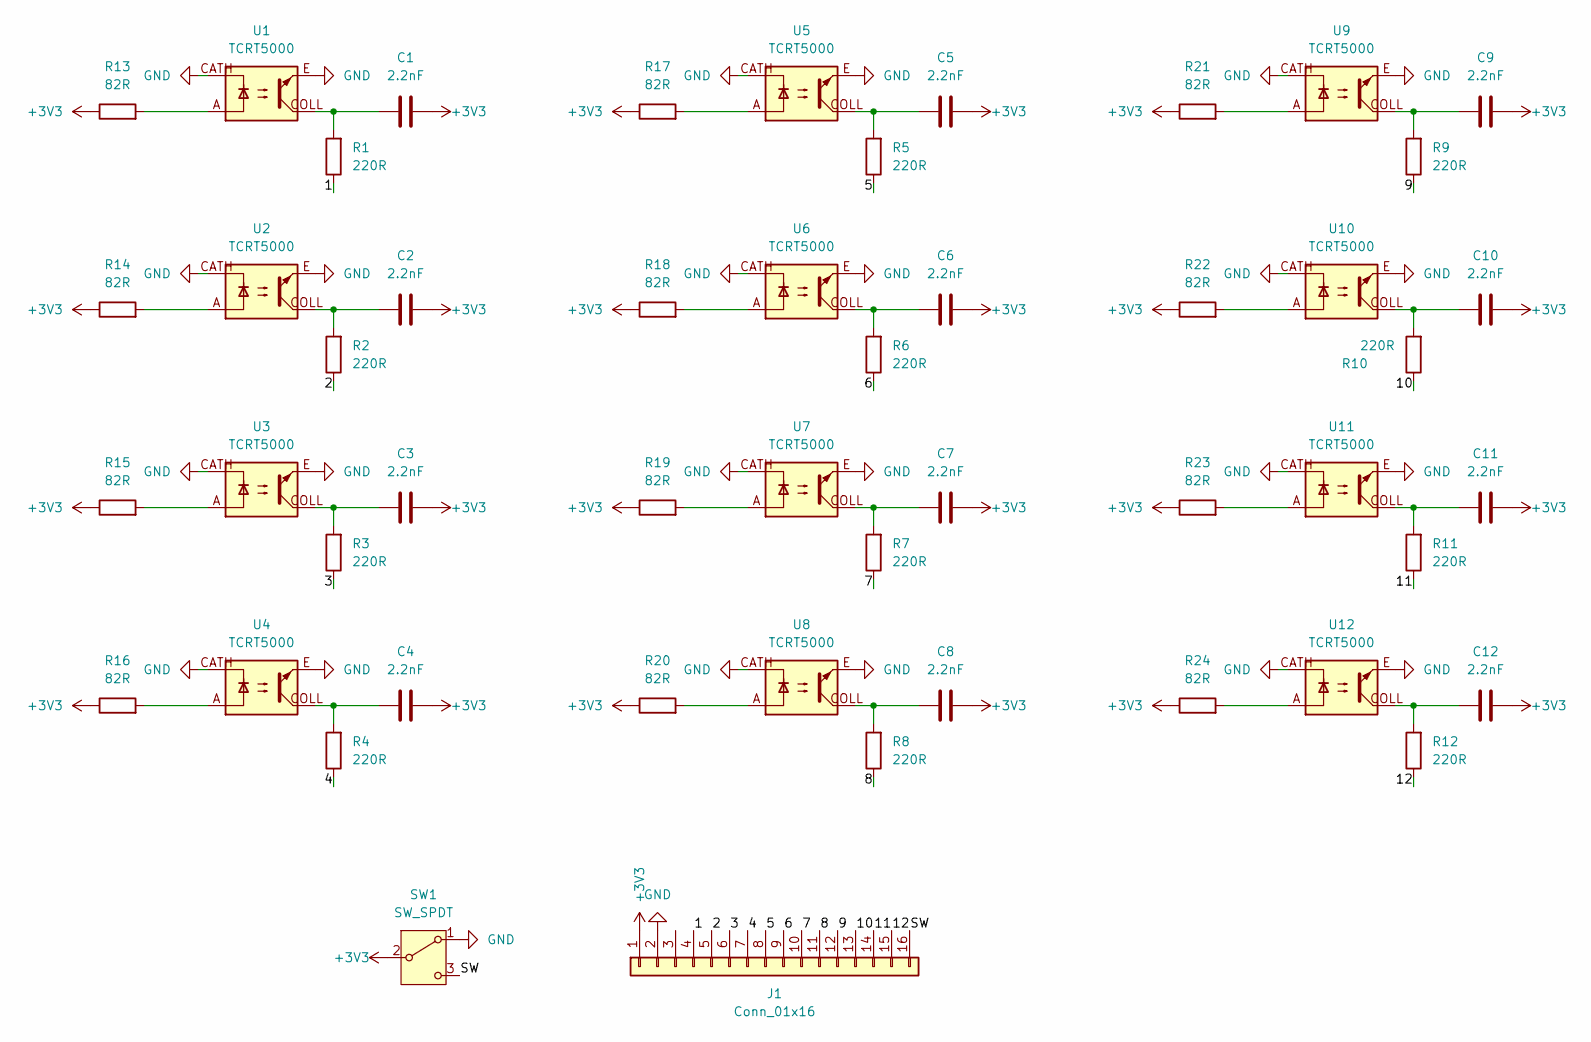
[picture p50: schematic Sensor Array.kicad_sch]

Parts:
C1, C2, C3, C4, C5, C6, C7, C8, C9, C10, C11, C12: 2.2nF; C_0805_2012Metric_Pad1.18x1.45mm_HandSolder
J1: Conn_01x16; PinHeader_1x16_P2.54mm_Vertical
R1, R2, R3, R4, R5, R6, R7, R8, R9, R10, R11, R12: 220R; R_0805_2012Metric_Pad1.20x1.40mm_HandSolder
R13, R14, R15, R16, R17, R18, R19, R20, R21, R22, R23, R24: 82R; R_0805_2012Metric_Pad1.20x1.40mm_HandSolder
SW1: SW_SPDT; SW_Slide_SPDT_Straight_CK_OS102011MS2Q
U1, U2, U3, U4, U5, U6, U7, U8, U9, U10, U11, U12: TCRT5000; tcrt5000

Connections:
+3V3: C1.2, C2.2, C3.2, C4.2, C5.2, C6.2, C7.2, C8.2, C9.2, C10.2, C11.2, C12.2, J1.1, R13.1, R14.1, R15.1, R16.1, R17.1, R18.1, R19.1, R20.1, R21.1, R22.1, R23.1, R24.1, SW1.2 (B)
/1: J1.4, R1.1
/2: J1.5, R2.1
/3: J1.6, R3.1
/4: J1.7, R4.1
/5: J1.8, R5.1
/6: J1.9, R6.1
/7: J1.10, R7.1
/8: J1.11, R8.1
/9: J1.12, R9.1
/10: J1.13, R10.1
/11: J1.14, R11.1
/12: J1.15, R12.1
/SW: J1.16, SW1.3 (C)
GND: J1.2, SW1.1 (A), U1.CATH, U1.E, U2.CATH, U2.E, U3.CATH, U3.E, U4.CATH, U4.E, U5.CATH, U5.E, U6.CATH, U6.E, U7.CATH, U7.E, U8.CATH, U8.E, U9.CATH, U9.E, U10.CATH, U10.E, U11.CATH, U11.E, U12.CATH, U12.E
unnamed: C1.1, R1.2, U1.COLL
unnamed: C2.1, R2.2, U2.COLL
unnamed: C3.1, R3.2, U3.COLL
unnamed: C4.1, R4.2, U4.COLL
unnamed: C5.1, R5.2, U5.COLL
unnamed: C6.1, R6.2, U6.COLL
unnamed: C7.1, R7.2, U7.COLL
unnamed: C8.1, R8.2, U8.COLL
unnamed: C9.1, R9.2, U9.COLL
unnamed: C10.1, R10.2, U10.COLL
unnamed: C11.1, R11.2, U11.COLL
unnamed: C12.1, R12.2, U12.COLL
unnamed: R13.2, U1.A
unnamed: R14.2, U2.A
unnamed: R15.2, U3.A
unnamed: R16.2, U4.A
unnamed: R17.2, U5.A
unnamed: R18.2, U6.A
unnamed: R19.2, U7.A
unnamed: R20.2, U8.A
unnamed: R21.2, U9.A
unnamed: R22.2, U10.A
unnamed: R23.2, U11.A
unnamed: R24.2, U12.A

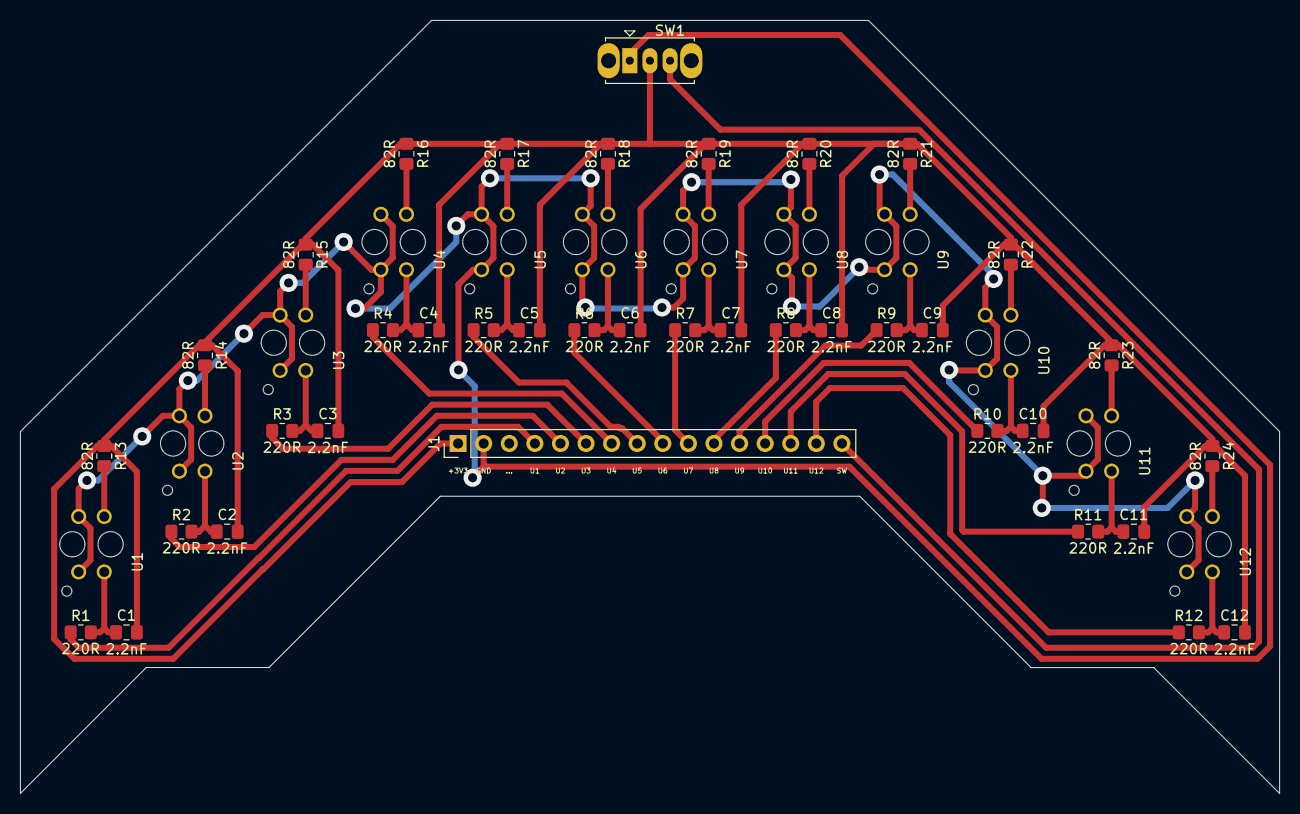
[picture p51: board Sensor Array/Sensor Array.kicad_pcb from above]

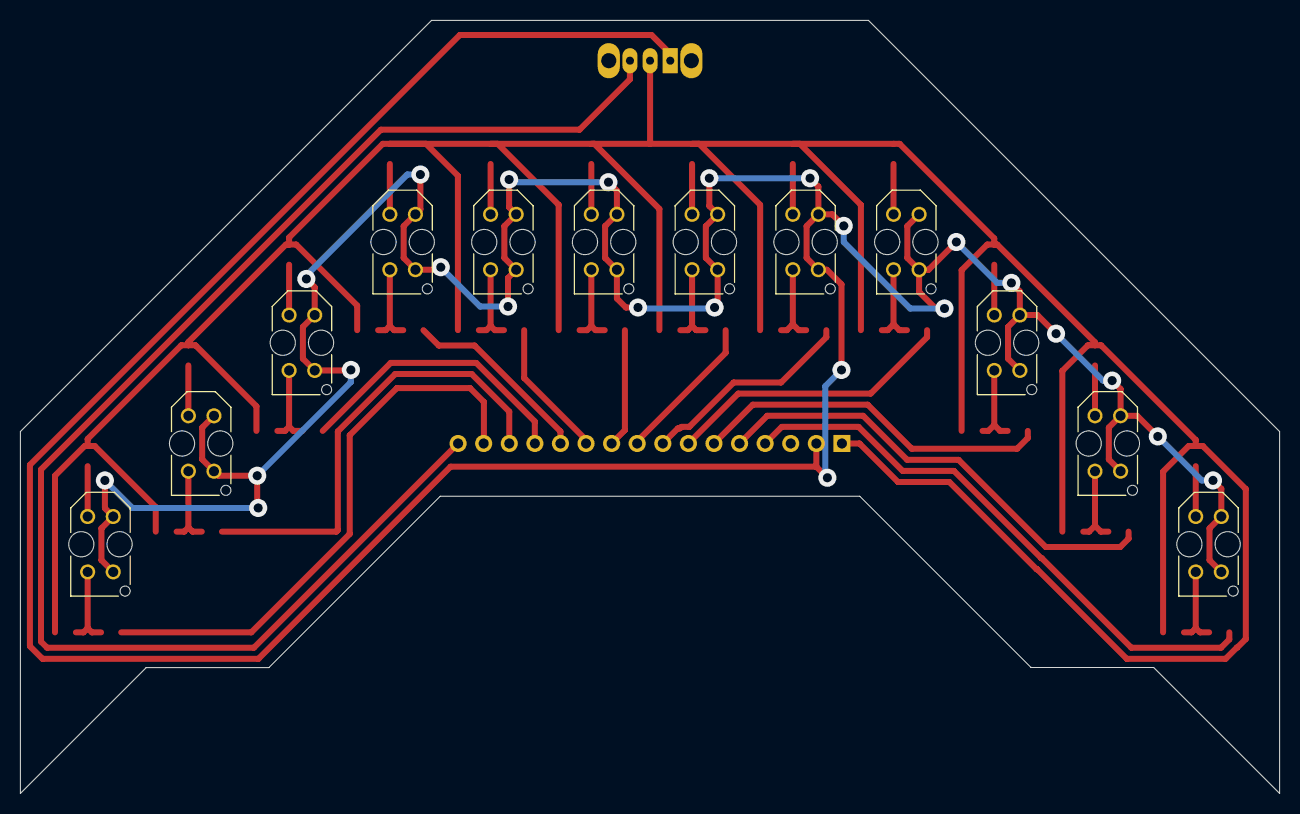
[picture p52: board Sensor Array/Sensor Array.kicad_pcb from below]

Board: 2 copper layers, 125.0 x 76.7 mm, 50 parts (12 on the bottom side), 39 nets.
