bsce26023/LFR/(commit log)

2026-05-14 Sensor Array
2026-06-18 Sensor Array Finalized
2026-06-20 Updated Readme, Added BOM
2026-06-20 Updated BOM
2026-07-14 Added Assembly Instructions
2026-08-05 Added Assembly link
